rohamid/siplex-som-s16/doc/Screenshot from 2024-08-30 15-36-36.png

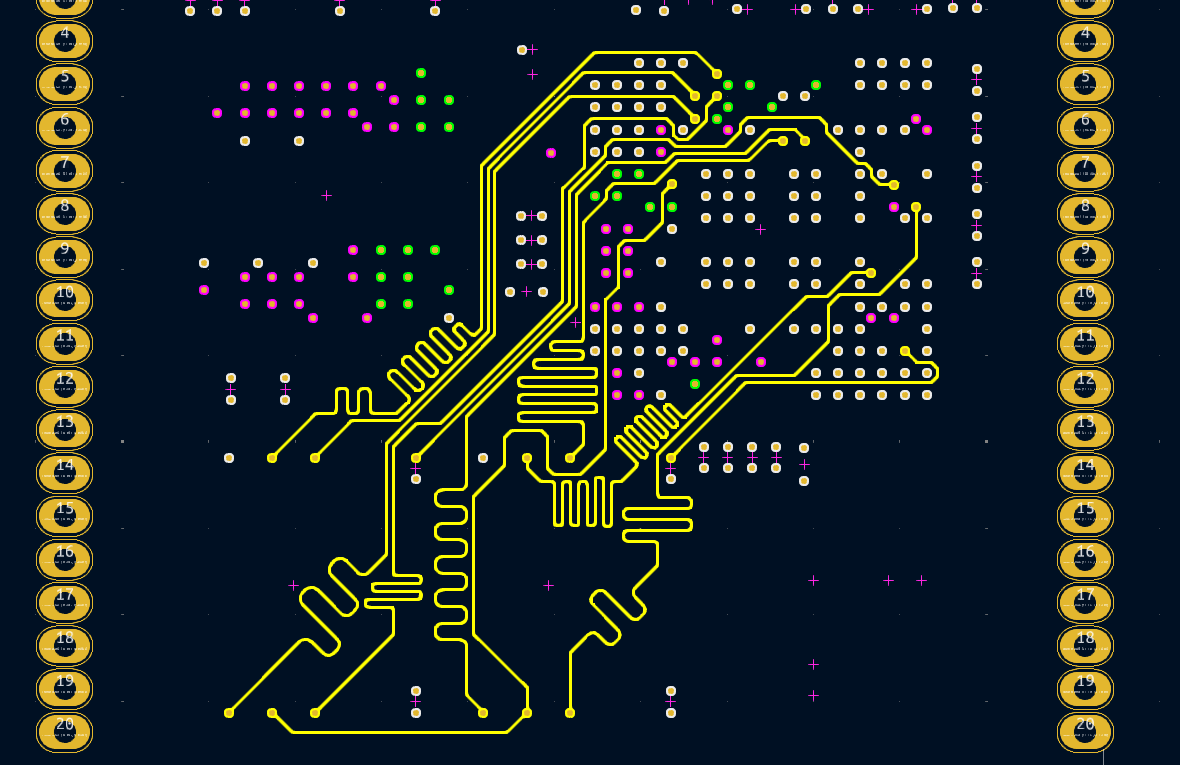
doc/Screenshot from 2024-08-30 15-36-36.png
