rohamid/siplex-som-s16/siplex-som-s16.step

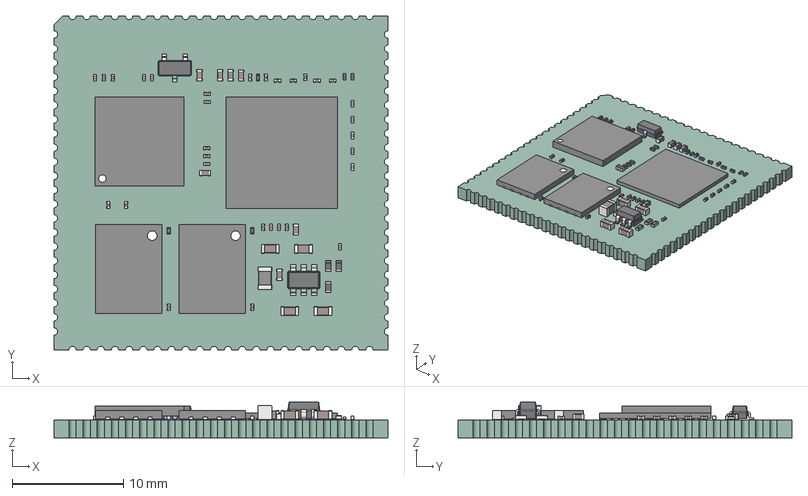
[picture p4: CAD file, 2024-09-13]
siplex-som-s16.step
30.0 x 30.0 x 3.20 mm
C_0201_0603Metric x 31
C_0603_1608Metric x 4
MT25QU01GBBB1EW9-0SIT TR x 2
C_0402_1005Metric x 6
R_0201_0603Metric x 5
R_0402_1005Metric x 3
STM32F765IIK6
IS42S16400J-6BLI
L_0805_2012Metric
SOT_23
SOT_23_6
L_0402_1005Metric
siplex-som-s16_PCB
