rohamid/siplex-som-s16/doc/siplex-som-s16.pdf

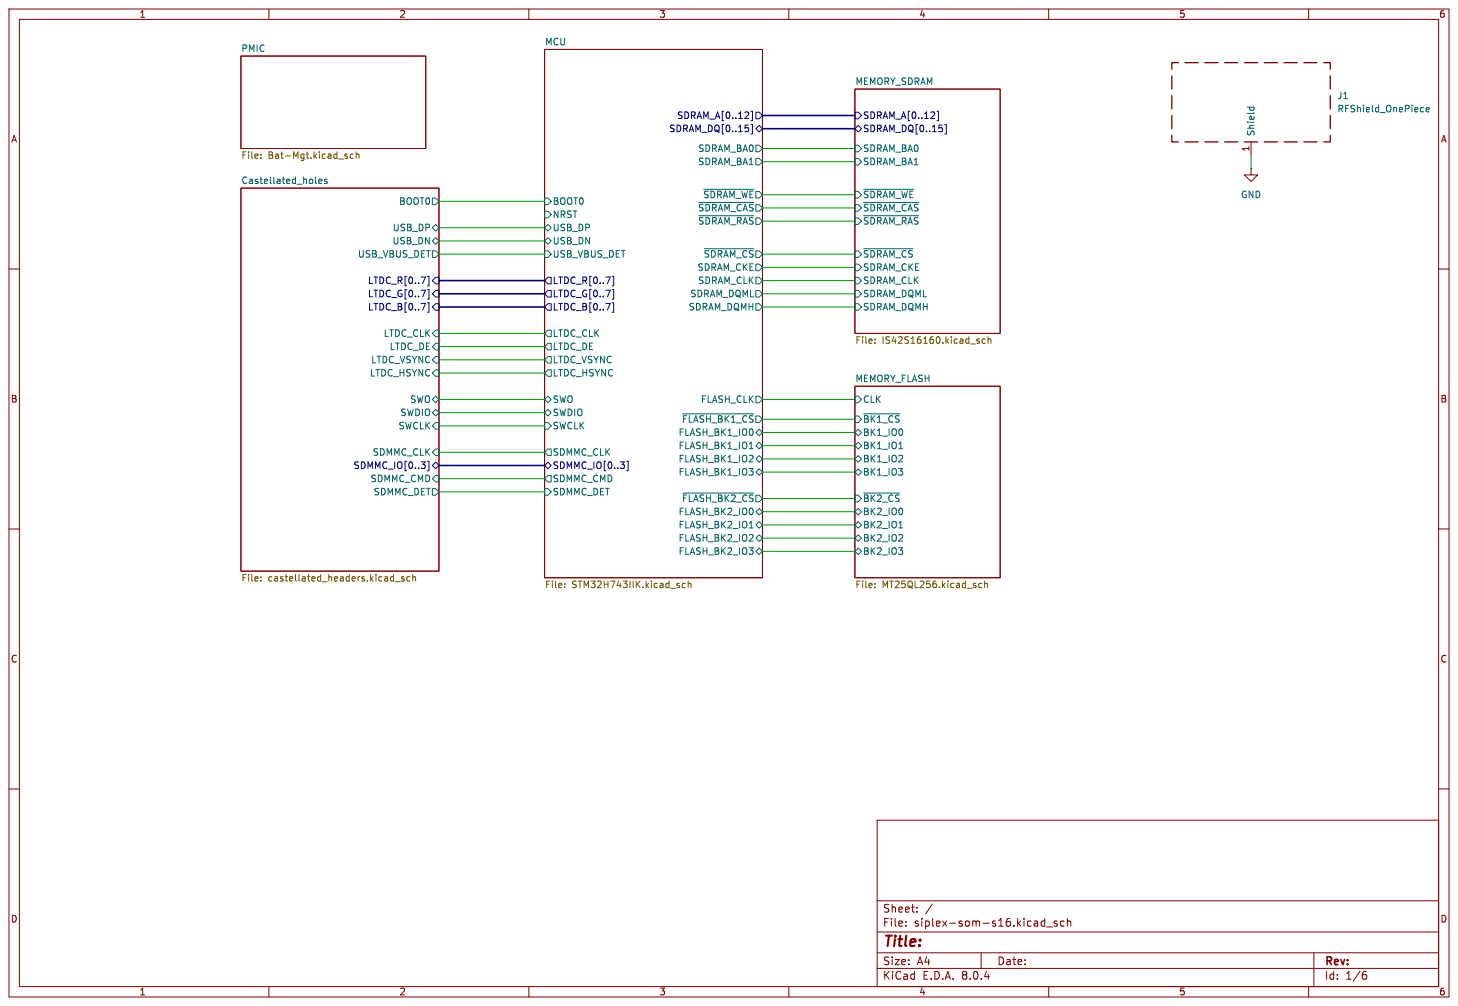
[picture p5: page 1]

~{SDRAM_CS} SDRAM_DQMH
BK2_IO3 BK1_IO2 ~{BK1_CS} BK1_IO0 BK1_IO1 BK1_IO3 MEMORY_FLASH
Id: 1/6 Title: File: siplex-som-s16.kicad_sch Sheet: / BK2_IO2 BK2_IO0 ~{BK2_CS} BK2_IO1 CLK

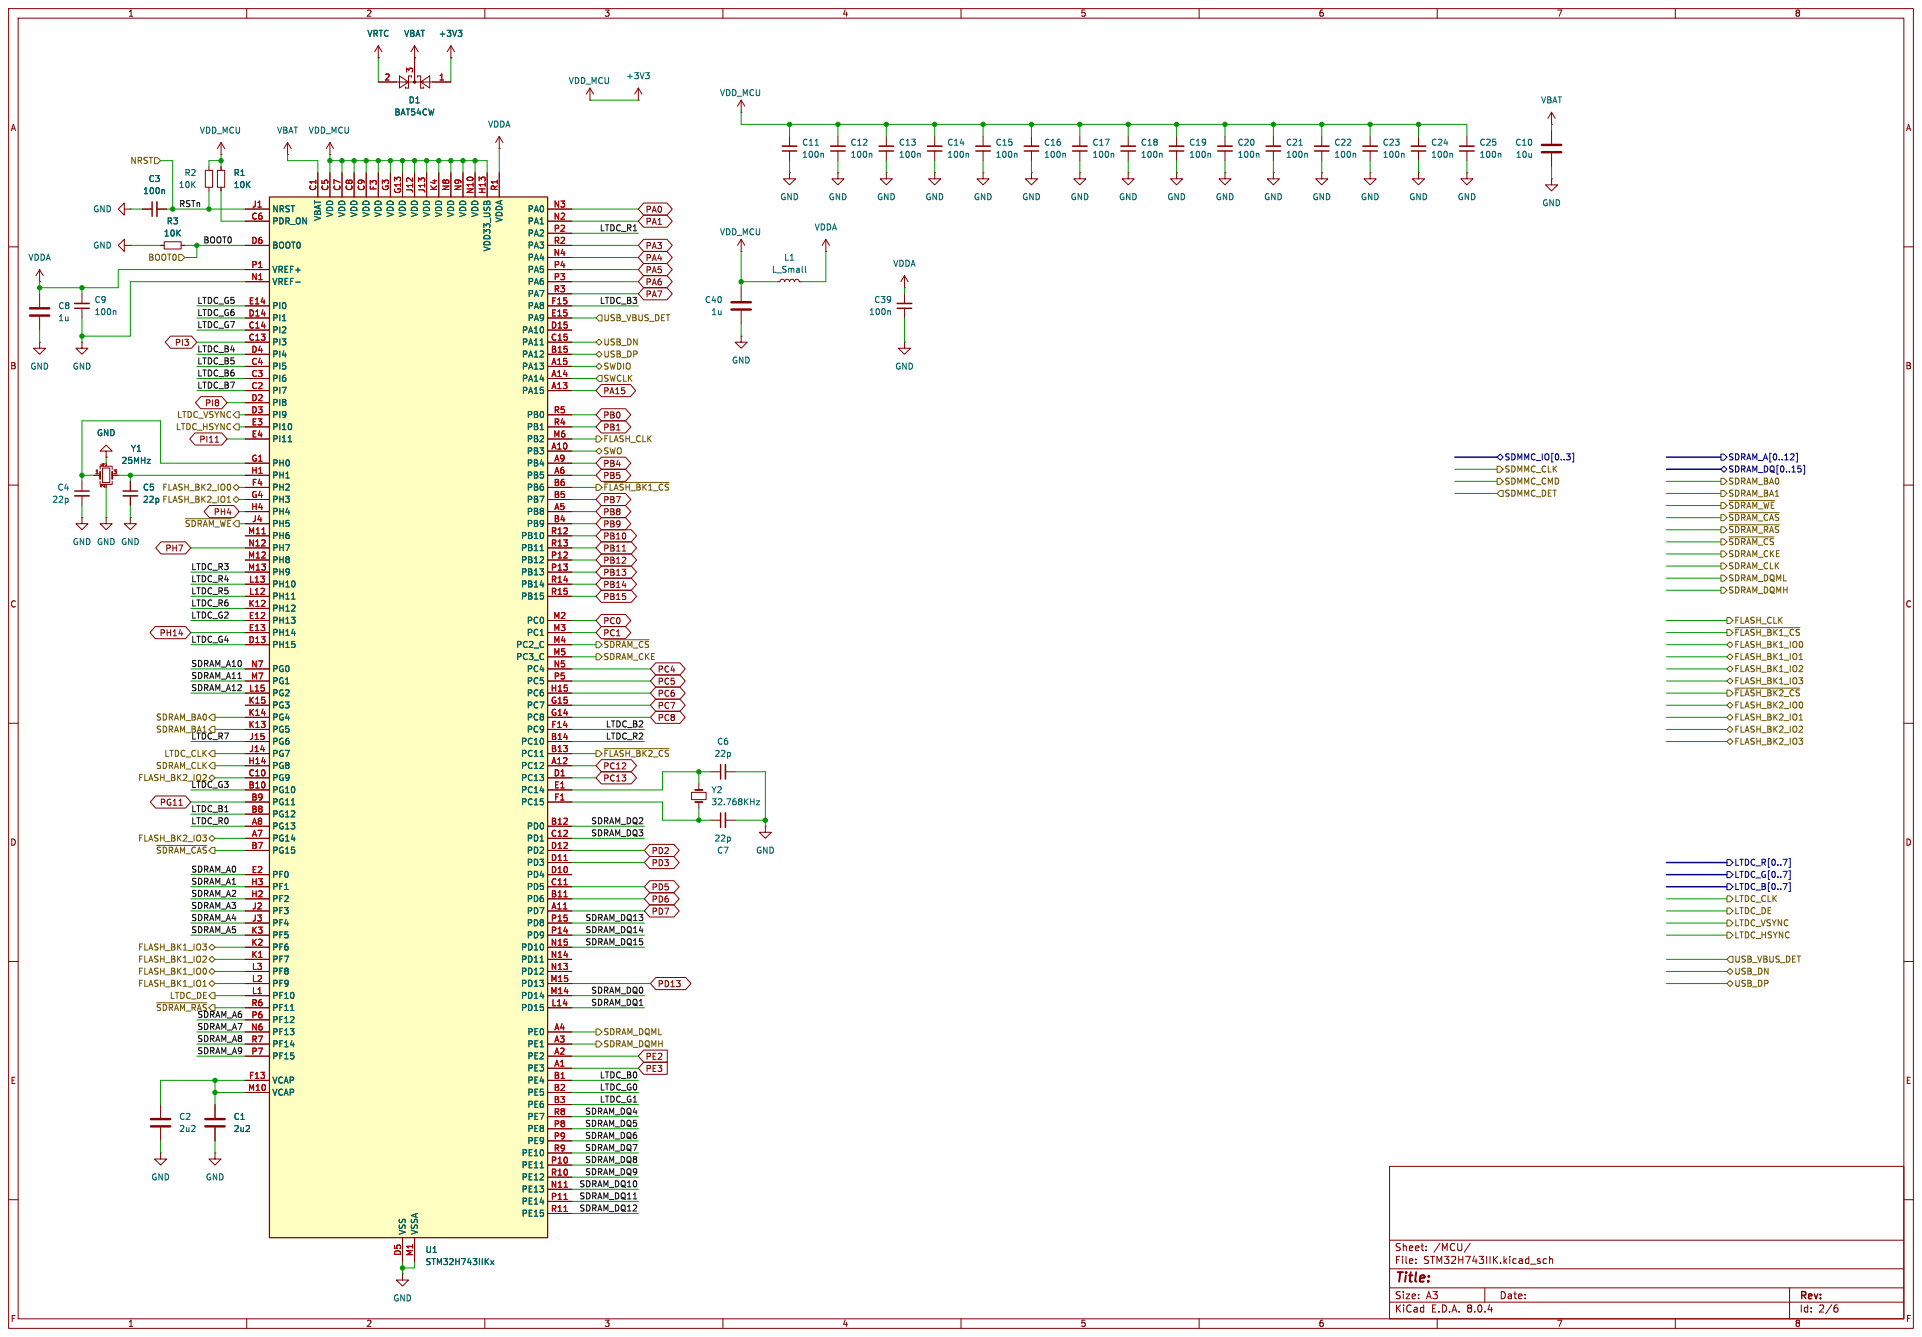
[picture p6: page 2]

Id: 2/6 Title: File: STM32H743IIK.kicad_sch Sheet: /MCU/

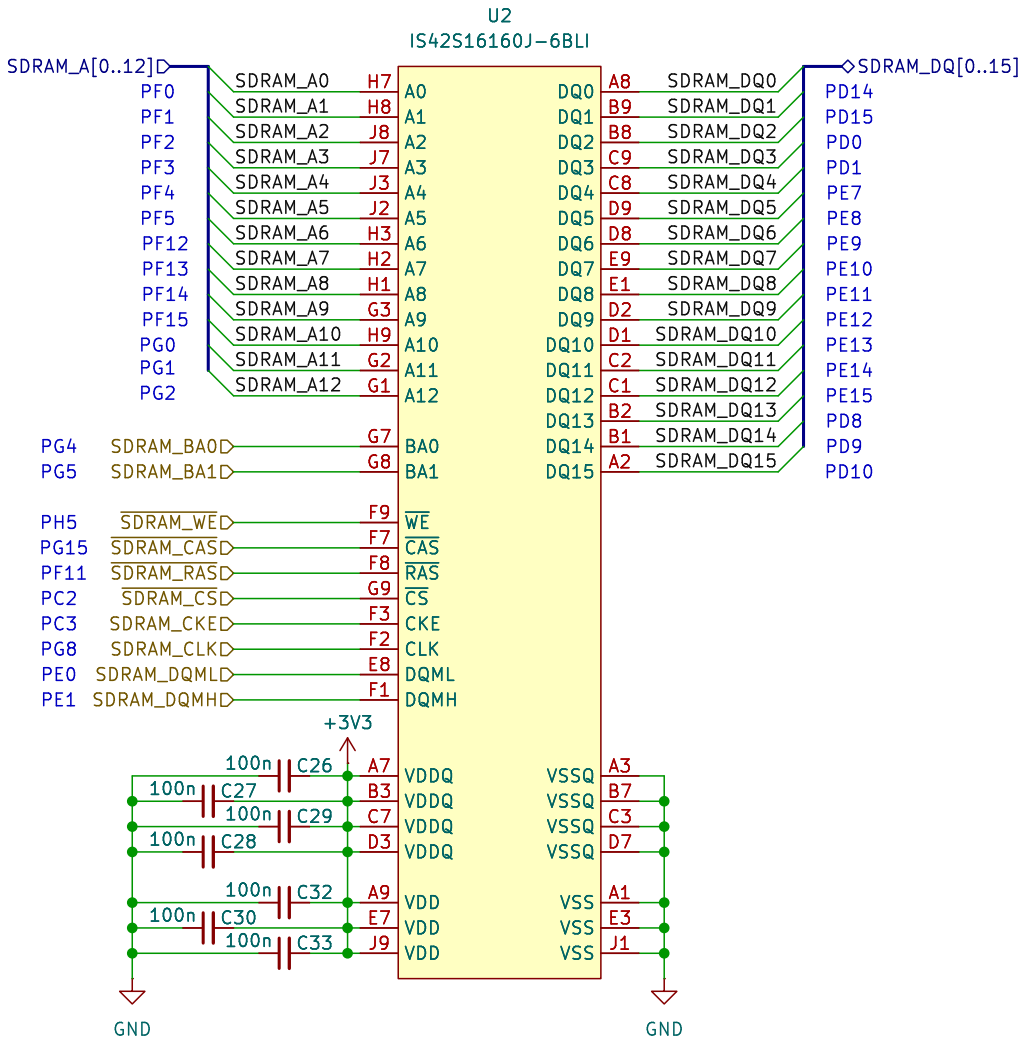
[picture p7: page 3]

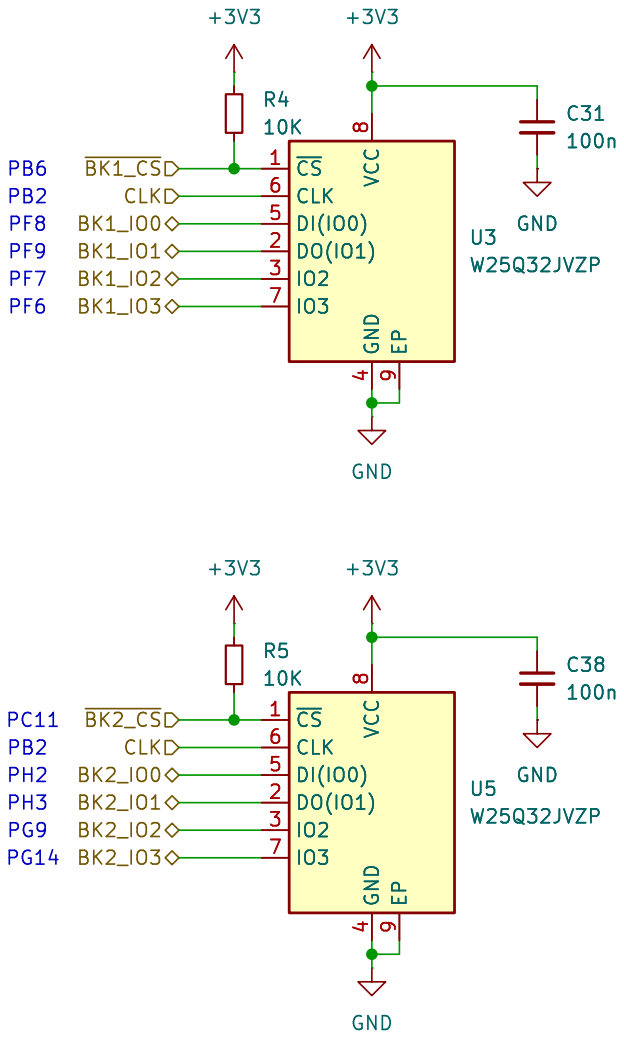
[picture p8: page 4]

Id: 4/6 Title: File: MT25QL256.kicad_sch Sheet: /MEMORY_FLASH/

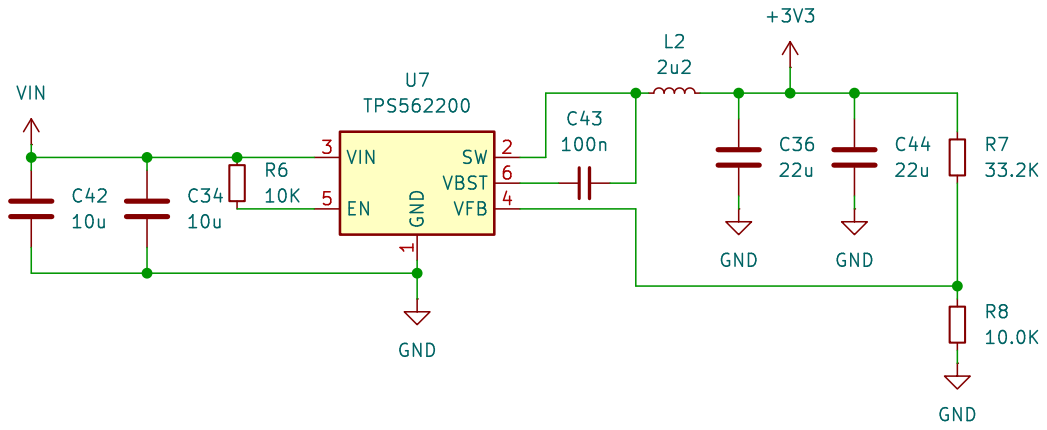
[picture p9: page 5]

1 SW 2 VIN 3 VFB 4 EN 5 VBST 6 U7 TPS562200 C42

Id: 5/6 Title: File: Bat-Mgt.kicad_sch Sheet: /PMIC/

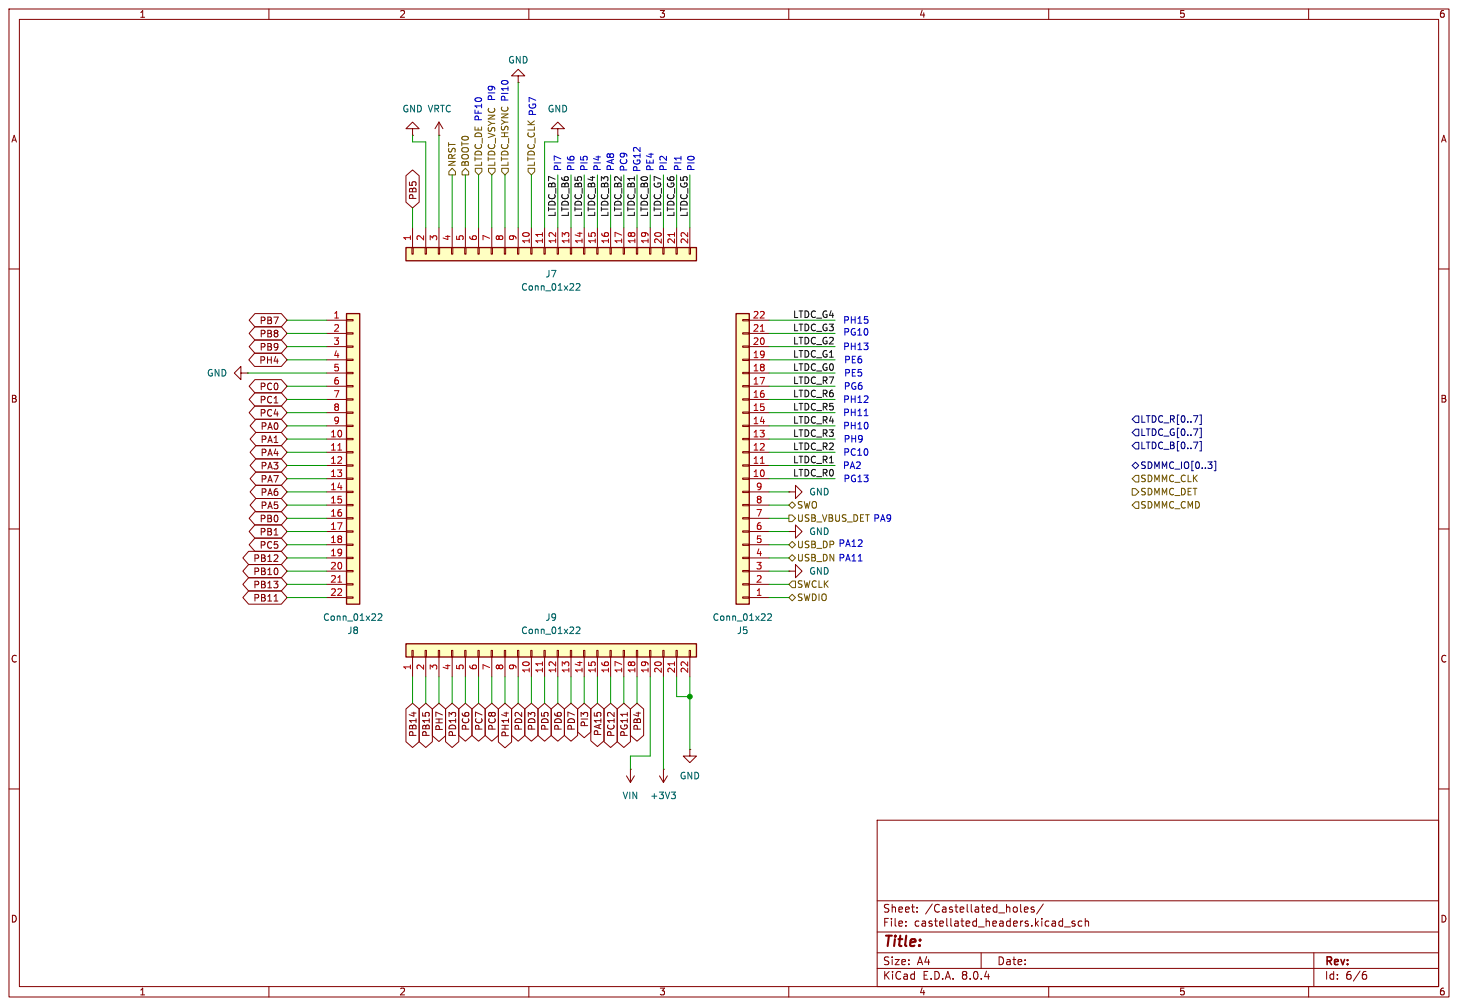
[picture p10: page 6]

Id: 6/6 Title: File: castellated_headers.kicad_sch Sheet: /Castellated_holes/
