rohamid/siplex-som-s16/siplex-som-s16.kicad_pcb

## KiCad design siplex-som-s16.kicad_pcb (2024-10-13)

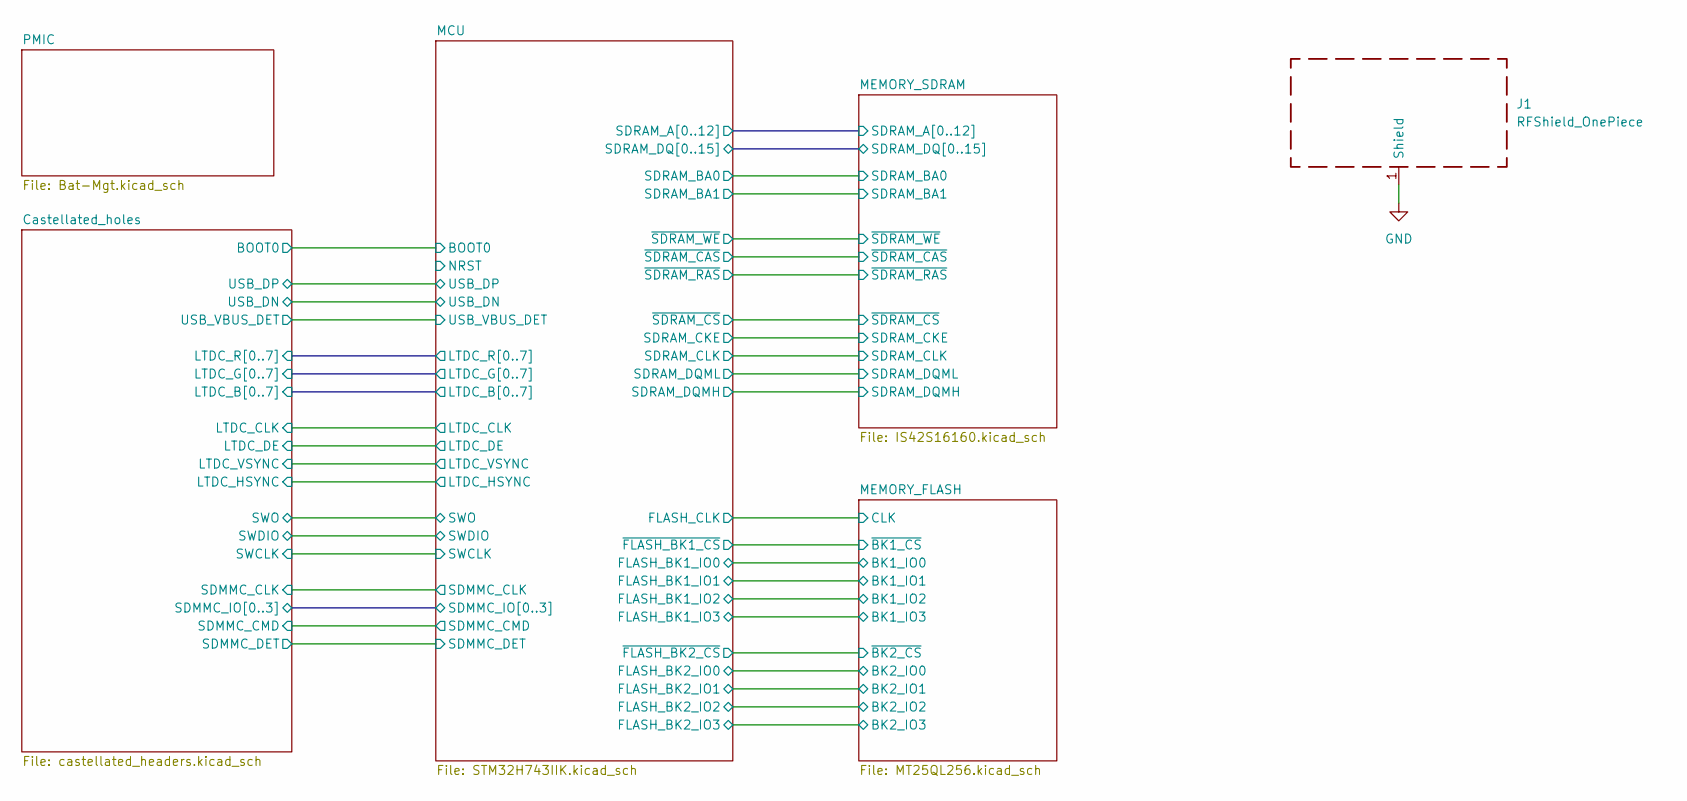
[picture p11: schematic siplex-som-s16.kicad_sch]

Parts:
J1: RFShield_OnePiece; Laird_Technologies_BMI-S-103_26.21x26.21mm

Connections:
GND: J1.1 (Shield); also elsewhere on the board

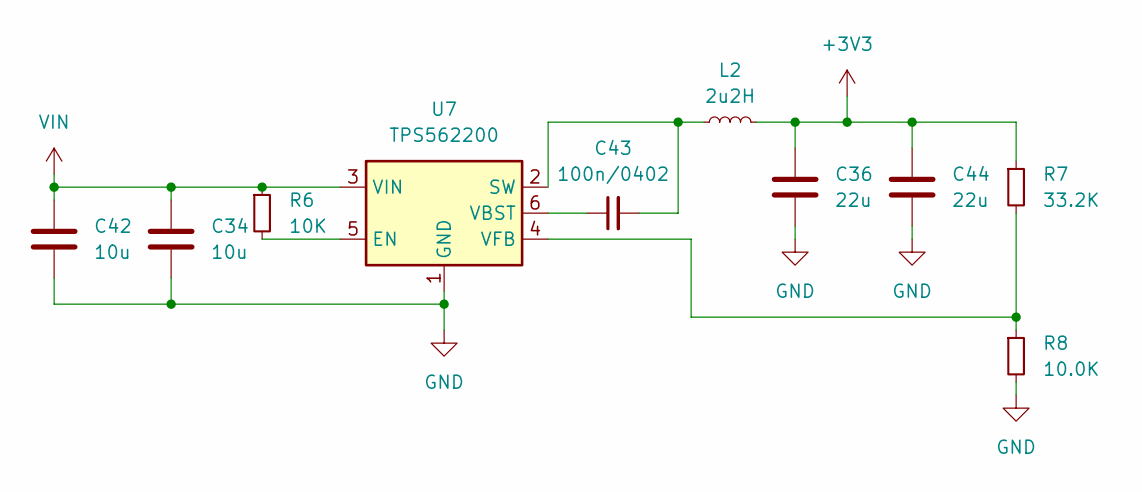
[picture p12: schematic Bat-Mgt.kicad_sch]

Parts:
C34, C42: 10u; C_0603_1608Metric; JLCPCB Part # C96446
C36, C44: 22u; C_0603_1608Metric; JLCPCB Part # C59461
C43: 100n/0402; C_0402_1005Metric; JLCPCB Part # C307331
L2: 2u2H; L_0805_2012Metric; JLCPCB Part # C162585
R6: 10K; R_0201_0603Metric; JLCPCB Part # C473048
R7: 33.2K; R_0402_1005Metric; JLCPCB Part # C226998
R8: 10.0K; R_0402_1005Metric; JLCPCB Part # C25804
U7: TPS562200; SOT-23-6; JLCPCB Part # C49757

Connections:
+3V3: C36.1, C44.1, L2.2, R7.1; also elsewhere on the board
GND: C34.2, C36.2, C42.2, C44.2, R8.2, U7.1 (GND); also elsewhere on the board
unnamed: R6.2, U7.5 (EN)
unnamed: C43.2, L2.1, U7.2 (SW)
unnamed: C43.1, U7.6 (VBST)
unnamed: R7.2, R8.1, U7.4 (VFB)
VIN: C34.1, C42.1, R6.1, U7.3 (VIN); also elsewhere on the board

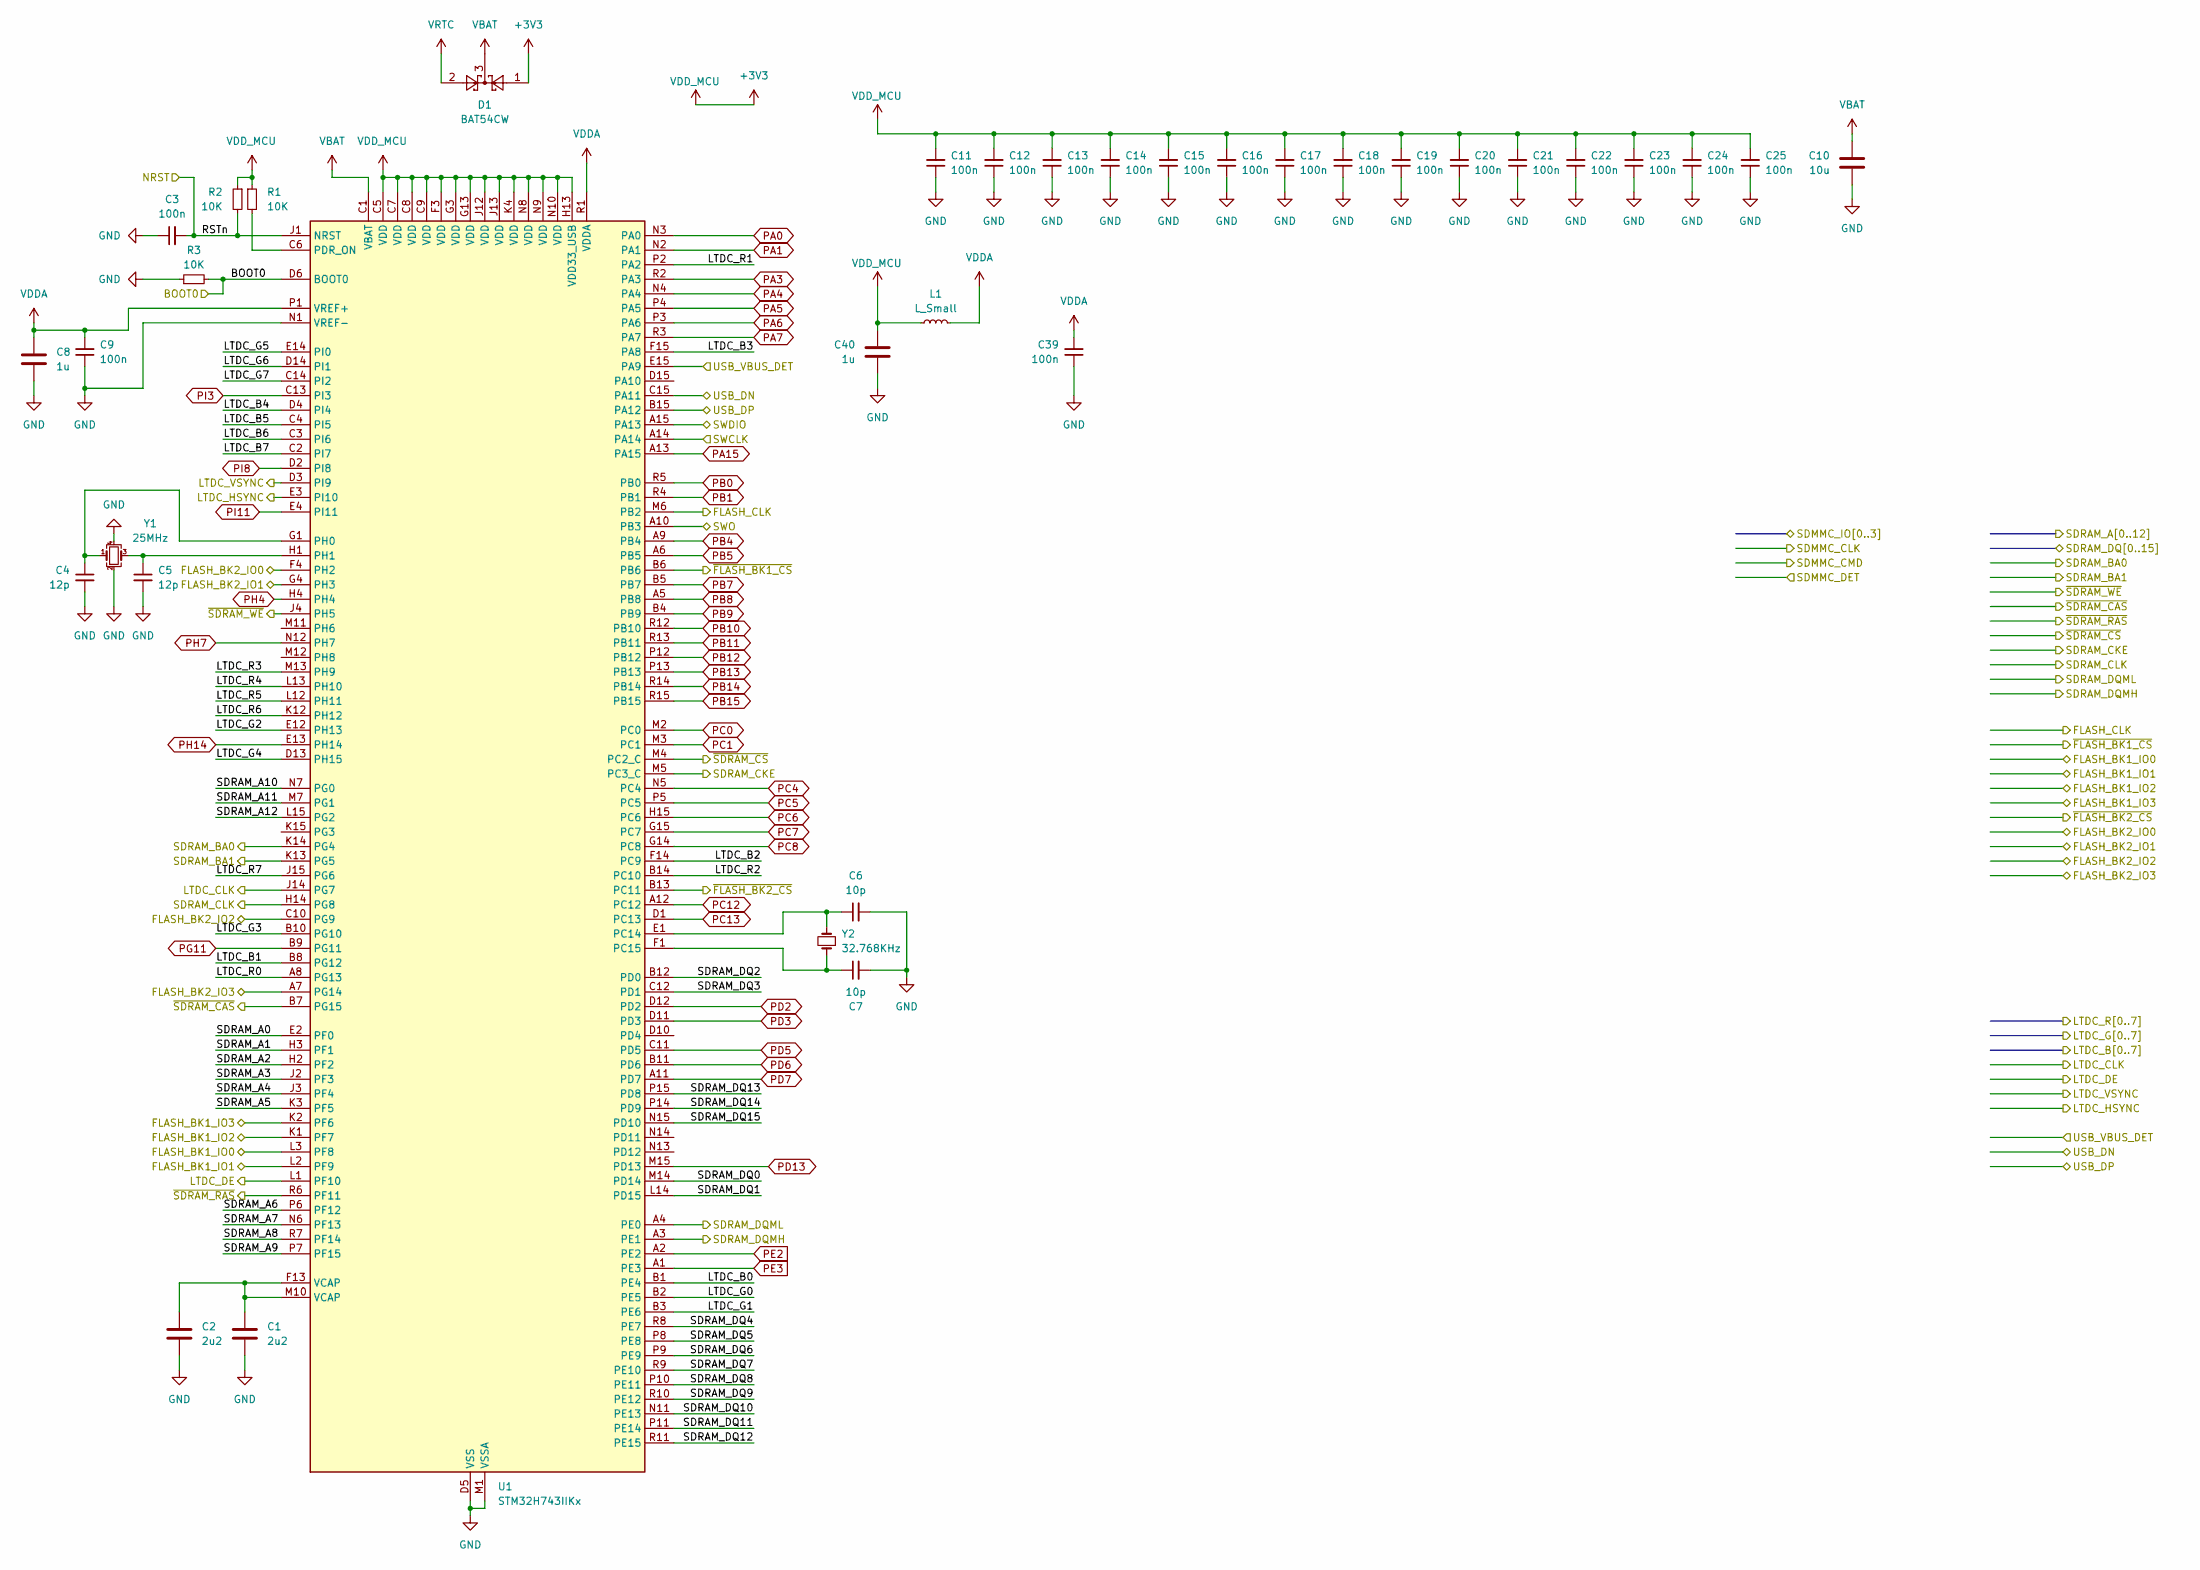
[picture p13: schematic STM32H743IIK.kicad_sch]

Parts:
C1, C2: 2u2; C_0402_1005Metric; JLCPCB Part # C12530
C3, C9, C11, C12, C13, C14, C15, C16, C17, C18, C19, C20, C21, C22, C23, C24, C25, C39: 100n; C_0201_0603Metric; JLCPCB Part # C307380
C4, C5: 12p; C_0201_0603Metric; JLCPCB Part # C277478
C6, C7: 10p; C_0201_0603Metric; JLCPCB Part # C76921
C8, C40: 1u; C_0402_1005Metric; JLCPCB Part # C52923
C10: 10u; C_0603_1608Metric; JLCPCB Part # C96446
D1: BAT54CW; SOT-23; JLCPCB Part # C37704
L1: L_Small; L_0402_1005Metric; JLCPCB Part # C76891
R1, R2, R3: 10K; R_0201_0603Metric; JLCPCB Part # C473048
U1: STM32H743IIKx; UFBGA-201_10x10mm_Layout15x15_P0.65mm; JLCPCB Part # C129442
Y1: 25MHz; Crystal_SMD_2016-4Pin_2.0x1.6mm; JLCPCB Part # C193187
Y2: 32.768KHz; Crystal_SMD_2012-2Pin_2.0x1.2mm; JLCPCB Part # C99009

Connections:
+3V3: C11.2, C12.2, C13.2, C14.2, C15.2, C16.2, C17.2, C18.2, C19.2, C20.2, C21.2, C22.2, C23.2, C24.2, C25.2, C40.1, D1.1, L1.1, R1.1, R2.1, U1.C5 (VDD), U1.C7 (VDD), U1.C8 (VDD), U1.C9 (VDD), U1.F3 (VDD), U1.G3 (VDD), U1.G13 (VDD), U1.H13 (VDD33_USB), U1.J12 (VDD), U1.J13 (VDD), U1.K4 (VDD), U1.N8 (VDD), U1.N9 (VDD), U1.N10 (VDD); also elsewhere on the board
/Castellated_holes/LTDC_B0: U1.B1 (PE4); also elsewhere on the board
/Castellated_holes/LTDC_B1: U1.B8 (PG12); also elsewhere on the board
/Castellated_holes/LTDC_B2: U1.F14 (PC9); also elsewhere on the board
/Castellated_holes/LTDC_B3: U1.F15 (PA8); also elsewhere on the board
/Castellated_holes/LTDC_B4: U1.D4 (PI4); also elsewhere on the board
/Castellated_holes/LTDC_B5: U1.C4 (PI5); also elsewhere on the board
/Castellated_holes/LTDC_B6: U1.C3 (PI6); also elsewhere on the board
/Castellated_holes/LTDC_B7: U1.C2 (PI7); also elsewhere on the board
/Castellated_holes/LTDC_CLK: U1.J14 (PG7); also elsewhere on the board
/Castellated_holes/LTDC_DE: U1.L1 (PF10); also elsewhere on the board
/Castellated_holes/LTDC_G0: U1.B2 (PE5); also elsewhere on the board
/Castellated_holes/LTDC_G1: U1.B3 (PE6); also elsewhere on the board
/Castellated_holes/LTDC_G2: U1.E12 (PH13); also elsewhere on the board
/Castellated_holes/LTDC_G3: U1.B10 (PG10); also elsewhere on the board
/Castellated_holes/LTDC_G4: U1.D13 (PH15); also elsewhere on the board
/Castellated_holes/LTDC_G5: U1.E14 (PI0); also elsewhere on the board
/Castellated_holes/LTDC_G6: U1.D14 (PI1); also elsewhere on the board
/Castellated_holes/LTDC_G7: U1.C14 (PI2); also elsewhere on the board
/Castellated_holes/LTDC_HSYNC: U1.E3 (PI10); also elsewhere on the board
/Castellated_holes/LTDC_R0: U1.A8 (PG13); also elsewhere on the board
/Castellated_holes/LTDC_R1: U1.P2 (PA2); also elsewhere on the board
/Castellated_holes/LTDC_R2: U1.B14 (PC10); also elsewhere on the board
/Castellated_holes/LTDC_R3: U1.M13 (PH9); also elsewhere on the board
/Castellated_holes/LTDC_R4: U1.L13 (PH10); also elsewhere on the board
/Castellated_holes/LTDC_R5: U1.L12 (PH11); also elsewhere on the board
/Castellated_holes/LTDC_R6: U1.K12 (PH12); also elsewhere on the board
/Castellated_holes/LTDC_R7: U1.J15 (PG6); also elsewhere on the board
/Castellated_holes/LTDC_VSYNC: U1.D3 (PI9); also elsewhere on the board
/Castellated_holes/SWCLK: U1.A14; also elsewhere on the board
/Castellated_holes/SWDIO: U1.A15 (PA13); also elsewhere on the board
/Castellated_holes/SWO: U1.A10 (PB3); also elsewhere on the board
/Castellated_holes/USB_DN: U1.C15 (PA11); also elsewhere on the board
/Castellated_holes/USB_DP: U1.B15 (PA12); also elsewhere on the board
/Castellated_holes/USB_VBUS_DET: U1.E15 (PA9); also elsewhere on the board
/MCU/BOOT0: R3.2, U1.D6 (BOOT0); also elsewhere on the board
/MCU/FLASH_BK1_IO0: U1.L3 (PF8); also elsewhere on the board
/MCU/FLASH_BK1_IO1: U1.L2 (PF9); also elsewhere on the board
/MCU/FLASH_BK1_IO2: U1.K1 (PF7); also elsewhere on the board
/MCU/FLASH_BK1_IO3: U1.K2 (PF6); also elsewhere on the board
/MCU/FLASH_BK2_IO0: U1.F4 (PH2); also elsewhere on the board
/MCU/FLASH_BK2_IO1: U1.G4 (PH3); also elsewhere on the board
/MCU/FLASH_BK2_IO2: U1.C10 (PG9); also elsewhere on the board
/MCU/FLASH_BK2_IO3: U1.A7 (PG14); also elsewhere on the board
/MCU/FLASH_CLK: U1.M6 (PB2); also elsewhere on the board
/MCU/RSTn: C3.2, R2.2, U1.J1 (NRST)
/MCU/SDRAM_A0: U1.E2 (PF0); also elsewhere on the board
/MCU/SDRAM_A1: U1.H3 (PF1); also elsewhere on the board
/MCU/SDRAM_A2: U1.H2 (PF2); also elsewhere on the board
/MCU/SDRAM_A3: U1.J2 (PF3); also elsewhere on the board
/MCU/SDRAM_A4: U1.J3 (PF4); also elsewhere on the board
/MCU/SDRAM_A5: U1.K3 (PF5); also elsewhere on the board
/MCU/SDRAM_A6: U1.P6 (PF12); also elsewhere on the board
/MCU/SDRAM_A7: U1.N6 (PF13); also elsewhere on the board
/MCU/SDRAM_A8: U1.R7 (PF14); also elsewhere on the board
/MCU/SDRAM_A9: U1.P7 (PF15); also elsewhere on the board
/MCU/SDRAM_A10: U1.N7 (PG0); also elsewhere on the board
/MCU/SDRAM_A11: U1.M7 (PG1); also elsewhere on the board
/MCU/SDRAM_A12: U1.L15 (PG2); also elsewhere on the board
/MCU/SDRAM_BA0: U1.K14 (PG4); also elsewhere on the board
/MCU/SDRAM_BA1: U1.K13 (PG5); also elsewhere on the board
/MCU/SDRAM_CKE: U1.M5 (PC3_C); also elsewhere on the board
/MCU/SDRAM_CLK: U1.H14 (PG8); also elsewhere on the board
/MCU/SDRAM_DQ0: U1.M14 (PD14); also elsewhere on the board
/MCU/SDRAM_DQ1: U1.L14 (PD15); also elsewhere on the board
/MCU/SDRAM_DQ2: U1.B12 (PD0); also elsewhere on the board
/MCU/SDRAM_DQ3: U1.C12 (PD1); also elsewhere on the board
/MCU/SDRAM_DQ4: U1.R8 (PE7); also elsewhere on the board
/MCU/SDRAM_DQ5: U1.P8 (PE8); also elsewhere on the board
/MCU/SDRAM_DQ6: U1.P9 (PE9); also elsewhere on the board
/MCU/SDRAM_DQ7: U1.R9 (PE10); also elsewhere on the board
/MCU/SDRAM_DQ8: U1.P10 (PE11); also elsewhere on the board
/MCU/SDRAM_DQ9: U1.R10 (PE12); also elsewhere on the board
/MCU/SDRAM_DQ10: U1.N11 (PE13); also elsewhere on the board
/MCU/SDRAM_DQ11: U1.P11 (PE14); also elsewhere on the board
/MCU/SDRAM_DQ12: U1.R11 (PE15); also elsewhere on the board
/MCU/SDRAM_DQ13: U1.P15 (PD8); also elsewhere on the board
/MCU/SDRAM_DQ14: U1.P14 (PD9); also elsewhere on the board
/MCU/SDRAM_DQ15: U1.N15 (PD10); also elsewhere on the board
/MCU/SDRAM_DQMH: U1.A3 (PE1); also elsewhere on the board
/MCU/SDRAM_DQML: U1.A4 (PE0); also elsewhere on the board
/MCU/~FLASH_BK1_CS: U1.B6; also elsewhere on the board
/MCU/~FLASH_BK2_CS: U1.B13 (PC11); also elsewhere on the board
/MCU/~SDRAM_CAS: U1.B7 (PG15); also elsewhere on the board
/MCU/~SDRAM_CS: U1.M4 (PC2_C); also elsewhere on the board
/MCU/~SDRAM_RAS: U1.R6 (PF11); also elsewhere on the board
/MCU/~SDRAM_WE: U1.J4 (PH5); also elsewhere on the board
GND: C1.2, C2.2, C3.1, C4.2, C5.2, C6.2, C7.2, C8.2, C9.1, C10.2, C11.1, C12.1, C13.1, C14.1, C15.1, C16.1, C17.1, C18.1, C19.1, C20.1, C21.1, C22.1, C23.1, C24.1, C25.1, C39.1, C40.2, R3.1, U1.D5 (VSS), U1.D7 (VSS), U1.D8 (VSS), U1.D9 (VSS), U1.F2 (VSS), U1.F6 (VSS), U1.F7 (VSS), U1.F8 (VSS), U1.F9 (VSS), U1.F10 (VSS), U1.F12 (VSS), U1.G2 (VSS), U1.G6 (VSS), U1.G7 (VSS), U1.G8 (VSS), U1.G9 (VSS), U1.G10 (VSS), U1.G12 (VSS), U1.H6 (VSS), U1.H7 (VSS), U1.H8 (VSS), U1.H9 (VSS), U1.H10 (VSS), U1.H12 (VSS), U1.J6 (VSS), U1.J7 (VSS), U1.J8 (VSS), U1.J9 (VSS), U1.J10 (VSS), U1.K6 (VSS), U1.K7 (VSS), U1.K8 (VSS), U1.K9 (VSS), U1.K10 (VSS), U1.L4 (VSS), U1.M1 (VSSA), U1.M8 (VSS), U1.M9 (VSS), U1.N1 (VREF-), Y1.2, Y1.4; also elsewhere on the board
unnamed: C1.1, C2.1, U1.F13 (VCAP), U1.M10 (VCAP)
unnamed: C6.1, U1.E1 (PC14), Y2.2
unnamed: C7.1, U1.F1 (PC15), Y2.1
unnamed: R1.2, U1.C6 (PDR_ON)
unnamed: C4.1, U1.G1 (PH0), Y1.1
unnamed: C5.1, U1.H1, Y1.3
PA0: U1.N3 (PA0); also elsewhere on the board
PA1: U1.N2 (PA1); also elsewhere on the board
PA3: U1.R2 (PA3); also elsewhere on the board
PA4: U1.N4 (PA4); also elsewhere on the board
PA5: U1.P4 (PA5); also elsewhere on the board
PA6: U1.P3 (PA6); also elsewhere on the board
PA7: U1.R3 (PA7); also elsewhere on the board
PA15: U1.A13 (PA15); also elsewhere on the board
PB0: U1.R5 (PB0); also elsewhere on the board
PB1: U1.R4 (PB1); also elsewhere on the board
PB4: U1.A9 (PB4); also elsewhere on the board
PB5: U1.A6 (PB5); also elsewhere on the board
PB7: U1.B5 (PB7); also elsewhere on the board
PB8: U1.A5 (PB8); also elsewhere on the board
PB9: U1.B4 (PB9); also elsewhere on the board
PB10: U1.R12 (PB10); also elsewhere on the board
PB11: U1.R13 (PB11); also elsewhere on the board
PB12: U1.P12 (PB12); also elsewhere on the board
PB13: U1.P13 (PB13); also elsewhere on the board
PB14: U1.R14 (PB14); also elsewhere on the board
PB15: U1.R15 (PB15); also elsewhere on the board
PC0: U1.M2 (PC0); also elsewhere on the board
PC1: U1.M3 (PC1); also elsewhere on the board
PC4: U1.N5 (PC4); also elsewhere on the board
PC5: U1.P5 (PC5); also elsewhere on the board
PC6: U1.H15 (PC6); also elsewhere on the board
PC7: U1.G15 (PC7); also elsewhere on the board
PC8: U1.G14 (PC8); also elsewhere on the board
PC12: U1.A12 (PC12); also elsewhere on the board
PC13: U1.D1 (PC13)
PD2: U1.D12 (PD2); also elsewhere on the board
PD3: U1.D11 (PD3); also elsewhere on the board
PD5: U1.C11 (PD5); also elsewhere on the board
PD6: U1.B11 (PD6); also elsewhere on the board
PD7: U1.A11 (PD7); also elsewhere on the board
PD13: U1.M15 (PD13); also elsewhere on the board
PE2: U1.A2 (PE2)
PE3: U1.A1 (PE3)
PG11: U1.B9 (PG11); also elsewhere on the board
PH4: U1.H4; also elsewhere on the board
PH7: U1.N12 (PH7); also elsewhere on the board
PH14: U1.E13 (PH14); also elsewhere on the board
PI3: U1.C13 (PI3); also elsewhere on the board
PI8: U1.D2 (PI8)
PI11: U1.E4 (PI11)
VBAT: C10.1, D1.3, U1.C1 (VBAT)
VDDA: C8.1, C9.2, C39.2, L1.2, U1.P1 (VREF+), U1.R1 (VDDA)
VRTC: D1.2; also elsewhere on the board

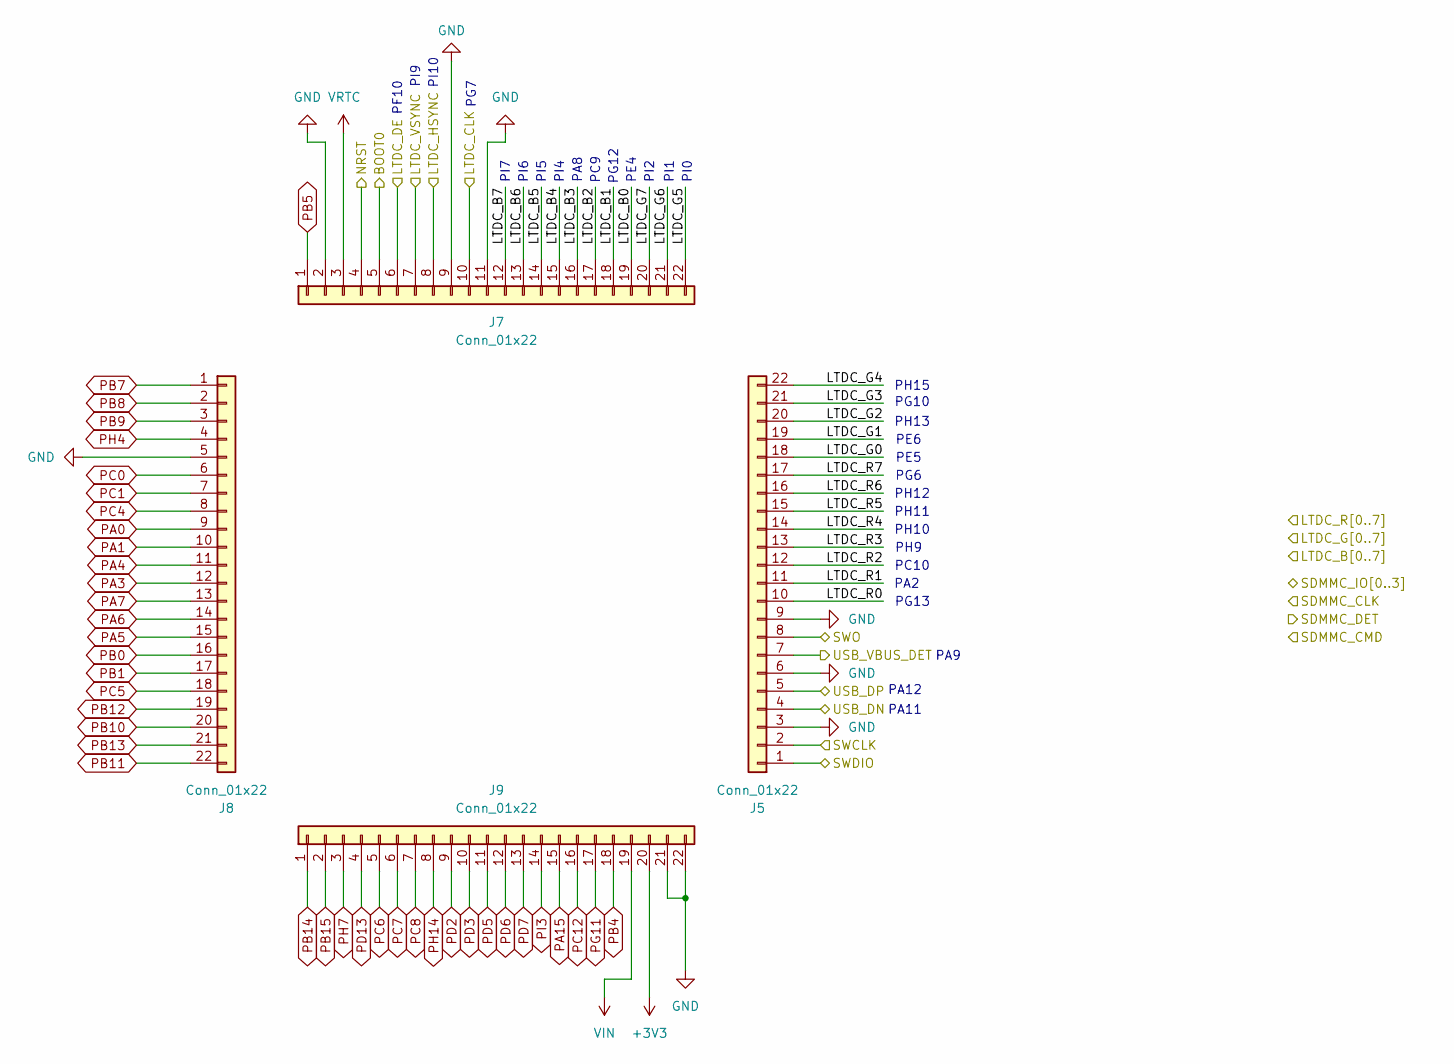
[picture p14: schematic castellated_headers.kicad_sch]

Parts:
J5, J7, J8, J9: Conn_01x22; castellated_01x22_P1.27mm

Connections:
+3V3: J9.20; also elsewhere on the board
/Castellated_holes/LTDC_B0: J7.19; also elsewhere on the board
/Castellated_holes/LTDC_B1: J7.18; also elsewhere on the board
/Castellated_holes/LTDC_B2: J7.17; also elsewhere on the board
/Castellated_holes/LTDC_B3: J7.16; also elsewhere on the board
/Castellated_holes/LTDC_B4: J7.15; also elsewhere on the board
/Castellated_holes/LTDC_B5: J7.14; also elsewhere on the board
/Castellated_holes/LTDC_B6: J7.13; also elsewhere on the board
/Castellated_holes/LTDC_B7: J7.12; also elsewhere on the board
/Castellated_holes/LTDC_CLK: J7.10; also elsewhere on the board
/Castellated_holes/LTDC_DE: J7.6; also elsewhere on the board
/Castellated_holes/LTDC_G0: J5.18; also elsewhere on the board
/Castellated_holes/LTDC_G1: J5.19; also elsewhere on the board
/Castellated_holes/LTDC_G2: J5.20; also elsewhere on the board
/Castellated_holes/LTDC_G3: J5.21; also elsewhere on the board
/Castellated_holes/LTDC_G4: J5.22; also elsewhere on the board
/Castellated_holes/LTDC_G5: J7.22; also elsewhere on the board
/Castellated_holes/LTDC_G6: J7.21; also elsewhere on the board
/Castellated_holes/LTDC_G7: J7.20; also elsewhere on the board
/Castellated_holes/LTDC_HSYNC: J7.8; also elsewhere on the board
/Castellated_holes/LTDC_R0: J5.10; also elsewhere on the board
/Castellated_holes/LTDC_R1: J5.11; also elsewhere on the board
/Castellated_holes/LTDC_R2: J5.12; also elsewhere on the board
/Castellated_holes/LTDC_R3: J5.13; also elsewhere on the board
/Castellated_holes/LTDC_R4: J5.14; also elsewhere on the board
/Castellated_holes/LTDC_R5: J5.15; also elsewhere on the board
/Castellated_holes/LTDC_R6: J5.16; also elsewhere on the board
/Castellated_holes/LTDC_R7: J5.17; also elsewhere on the board
/Castellated_holes/LTDC_VSYNC: J7.7; also elsewhere on the board
/Castellated_holes/NRST: J7.4
/Castellated_holes/SWCLK: J5.2; also elsewhere on the board
/Castellated_holes/SWDIO: J5.1; also elsewhere on the board
/Castellated_holes/SWO: J5.8; also elsewhere on the board
/Castellated_holes/USB_DN: J5.4; also elsewhere on the board
/Castellated_holes/USB_DP: J5.5; also elsewhere on the board
/Castellated_holes/USB_VBUS_DET: J5.7; also elsewhere on the board
/MCU/BOOT0: J7.5; also elsewhere on the board
GND: J5.3, J5.6, J5.9, J7.2, J7.9, J7.11, J8.5, J9.21, J9.22; also elsewhere on the board
PA0: J8.9; also elsewhere on the board
PA1: J8.10; also elsewhere on the board
PA3: J8.12; also elsewhere on the board
PA4: J8.11; also elsewhere on the board
PA5: J8.15; also elsewhere on the board
PA6: J8.14; also elsewhere on the board
PA7: J8.13; also elsewhere on the board
PA15: J9.15; also elsewhere on the board
PB0: J8.16; also elsewhere on the board
PB1: J8.17; also elsewhere on the board
PB4: J9.18; also elsewhere on the board
PB5: J7.1; also elsewhere on the board
PB7: J8.1; also elsewhere on the board
PB8: J8.2; also elsewhere on the board
PB9: J8.3; also elsewhere on the board
PB10: J8.20; also elsewhere on the board
PB11: J8.22; also elsewhere on the board
PB12: J8.19; also elsewhere on the board
PB13: J8.21; also elsewhere on the board
PB14: J9.1; also elsewhere on the board
PB15: J9.2; also elsewhere on the board
PC0: J8.6; also elsewhere on the board
PC1: J8.7; also elsewhere on the board
PC4: J8.8; also elsewhere on the board
PC5: J8.18; also elsewhere on the board
PC6: J9.5; also elsewhere on the board
PC7: J9.6; also elsewhere on the board
PC8: J9.7; also elsewhere on the board
PC12: J9.16; also elsewhere on the board
PD2: J9.9; also elsewhere on the board
PD3: J9.10; also elsewhere on the board
PD5: J9.11; also elsewhere on the board
PD6: J9.12; also elsewhere on the board
PD7: J9.13; also elsewhere on the board
PD13: J9.4; also elsewhere on the board
PG11: J9.17; also elsewhere on the board
PH4: J8.4; also elsewhere on the board
PH7: J9.3; also elsewhere on the board
PH14: J9.8; also elsewhere on the board
PI3: J9.14; also elsewhere on the board
VIN: J9.19; also elsewhere on the board
VRTC: J7.3; also elsewhere on the board

Notes on the sheet:
PC10
PI1
PA9
PI6
PG12
PF10
PI7
PI9
PA11
PA12
PG10
PI5
PG7
PI10
PH11
PH15
PI4
PG13
PC9
PH9
PI2
PH13
PA2
PH12
PH10
PA8
PE5
PE4
PI0
PG6
PE6

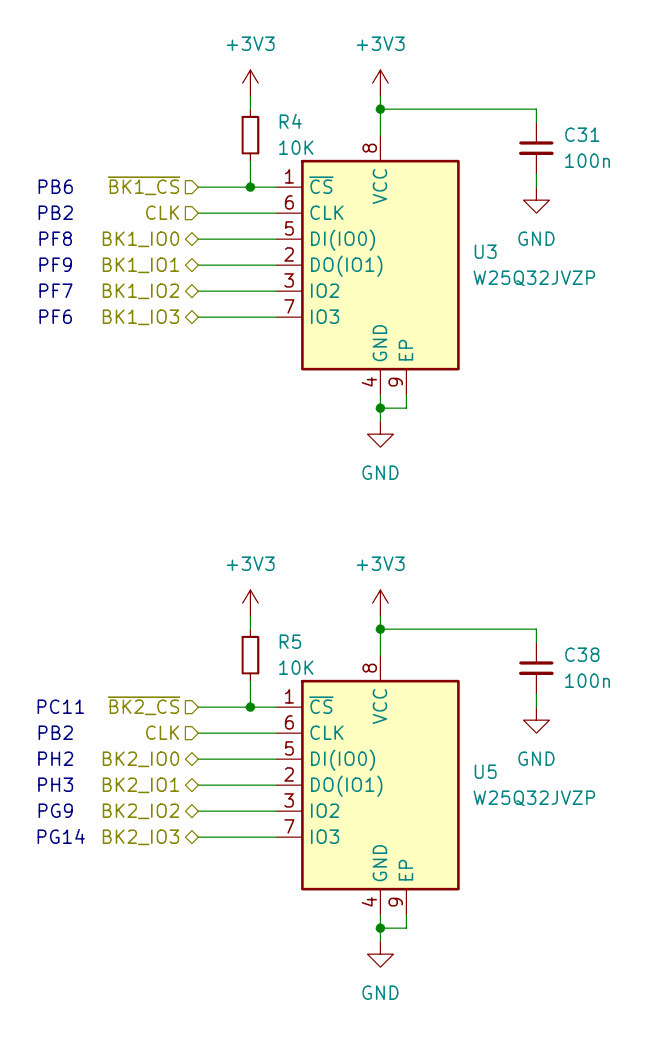
[picture p15: schematic MT25QL256.kicad_sch]

Parts:
C31, C38: 100n; C_0201_0603Metric; JLCPCB Part # C307380
R4, R5: 10K; R_0201_0603Metric; JLCPCB Part # C473048
U3, U5: W25Q32JVZP; WSON-8-1EP_8x6mm_P1.27mm_EP3.4x4.3mm; JLCPCB Part # C2986165

Connections:
+3V3: C31.1, C38.1, R4.1, R5.1, U3.8 (VCC), U5.8 (VCC); also elsewhere on the board
/MCU/FLASH_BK1_IO0: U3.5 (DI(IO0)); also elsewhere on the board
/MCU/FLASH_BK1_IO1: U3.2 (DO(IO1)); also elsewhere on the board
/MCU/FLASH_BK1_IO2: U3.3 (IO2); also elsewhere on the board
/MCU/FLASH_BK1_IO3: U3.7 (IO3); also elsewhere on the board
/MCU/FLASH_BK2_IO0: U5.5 (DI(IO0)); also elsewhere on the board
/MCU/FLASH_BK2_IO1: U5.2 (DO(IO1)); also elsewhere on the board
/MCU/FLASH_BK2_IO2: U5.3 (IO2); also elsewhere on the board
/MCU/FLASH_BK2_IO3: U5.7 (IO3); also elsewhere on the board
/MCU/FLASH_CLK: U3.6 (CLK), U5.6 (CLK); also elsewhere on the board
/MCU/~FLASH_BK1_CS: R4.2, U3.1 (~CS); also elsewhere on the board
/MCU/~FLASH_BK2_CS: R5.2, U5.1 (~CS); also elsewhere on the board
GND: C31.2, C38.2, U3.4 (GND), U3.9 (EP), U5.4 (GND), U5.9 (EP); also elsewhere on the board

Notes on the sheet:
PB6
PB2
PF7
PF8
PG9
PF6
PG14
PH3
PC11
PF9
PH2

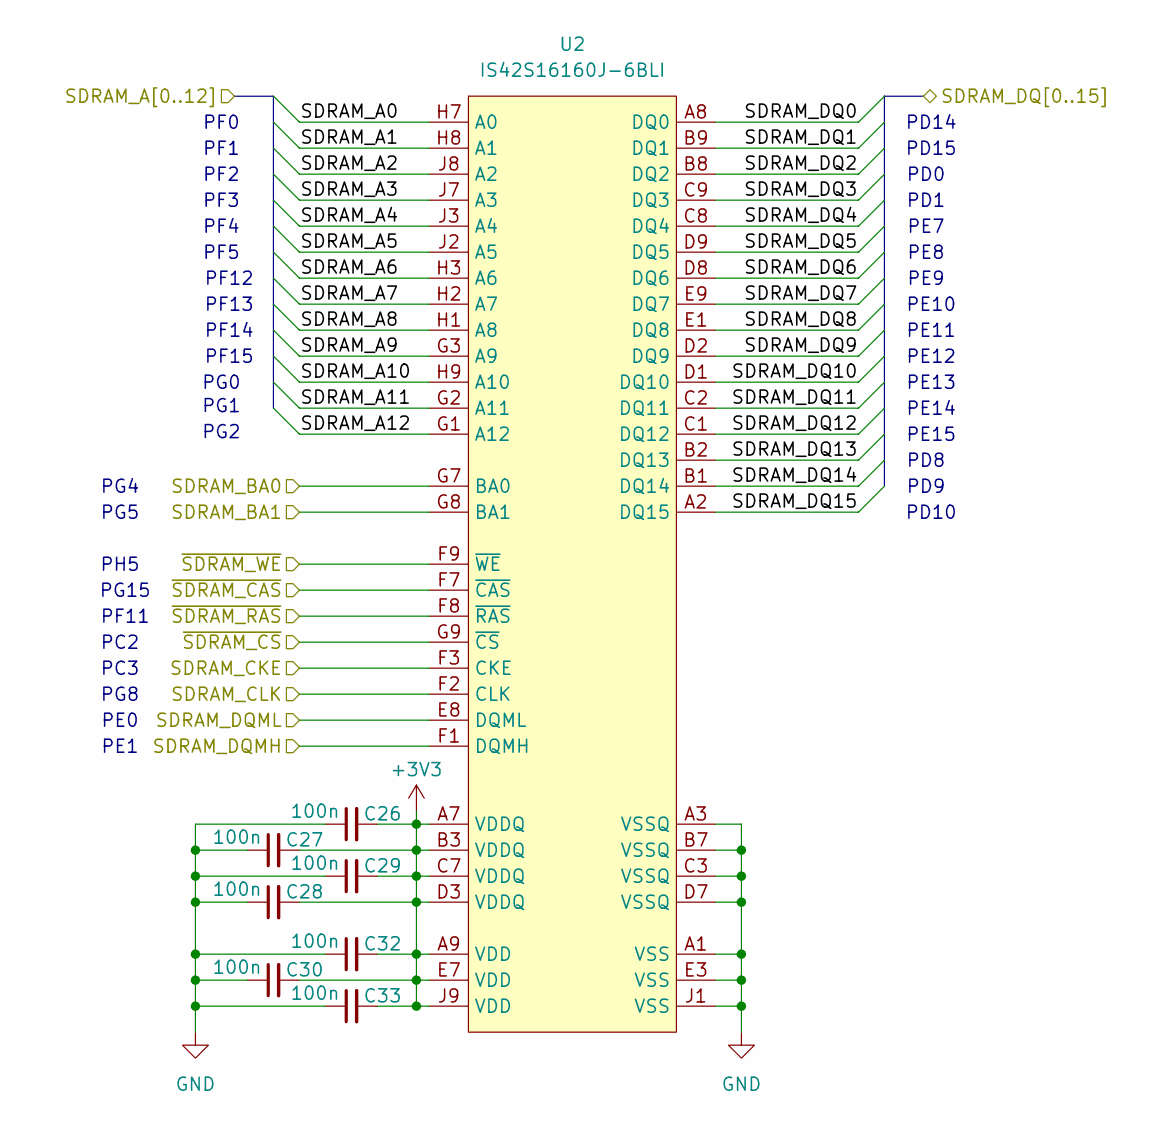
[picture p16: schematic IS42S16160.kicad_sch]

Parts:
C26, C27, C28, C29, C30, C32, C33: 100n; C_0201_0603Metric; JLCPCB Part # C307380
U2: IS42S16160J-6BLI; Alliance_TFBGA-54_8x8mm_Layout9x9_P0.8mm; JLCPCB Part # C1348766

Connections:
+3V3: C26.2, C27.2, C28.2, C29.2, C30.2, C32.2, C33.2, U2.A7 (VDDQ), U2.A9 (VDD), U2.B3 (VDDQ), U2.C7 (VDDQ), U2.D3 (VDDQ), U2.E7 (VDD), U2.J9 (VDD); also elsewhere on the board
/MCU/SDRAM_A0: U2.H7 (A0); also elsewhere on the board
/MCU/SDRAM_A1: U2.H8 (A1); also elsewhere on the board
/MCU/SDRAM_A2: U2.J8 (A2); also elsewhere on the board
/MCU/SDRAM_A3: U2.J7 (A3); also elsewhere on the board
/MCU/SDRAM_A4: U2.J3 (A4); also elsewhere on the board
/MCU/SDRAM_A5: U2.J2 (A5); also elsewhere on the board
/MCU/SDRAM_A6: U2.H3 (A6); also elsewhere on the board
/MCU/SDRAM_A7: U2.H2 (A7); also elsewhere on the board
/MCU/SDRAM_A8: U2.H1 (A8); also elsewhere on the board
/MCU/SDRAM_A9: U2.G3 (A9); also elsewhere on the board
/MCU/SDRAM_A10: U2.H9 (A10); also elsewhere on the board
/MCU/SDRAM_A11: U2.G2 (A11); also elsewhere on the board
/MCU/SDRAM_A12: U2.G1 (A12); also elsewhere on the board
/MCU/SDRAM_BA0: U2.G7 (BA0); also elsewhere on the board
/MCU/SDRAM_BA1: U2.G8 (BA1); also elsewhere on the board
/MCU/SDRAM_CKE: U2.F3 (CKE); also elsewhere on the board
/MCU/SDRAM_CLK: U2.F2 (CLK); also elsewhere on the board
/MCU/SDRAM_DQ0: U2.A8 (DQ0); also elsewhere on the board
/MCU/SDRAM_DQ1: U2.B9 (DQ1); also elsewhere on the board
/MCU/SDRAM_DQ2: U2.B8 (DQ2); also elsewhere on the board
/MCU/SDRAM_DQ3: U2.C9 (DQ3); also elsewhere on the board
/MCU/SDRAM_DQ4: U2.C8 (DQ4); also elsewhere on the board
/MCU/SDRAM_DQ5: U2.D9 (DQ5); also elsewhere on the board
/MCU/SDRAM_DQ6: U2.D8 (DQ6); also elsewhere on the board
/MCU/SDRAM_DQ7: U2.E9 (DQ7); also elsewhere on the board
/MCU/SDRAM_DQ8: U2.E1 (DQ8); also elsewhere on the board
/MCU/SDRAM_DQ9: U2.D2 (DQ9); also elsewhere on the board
/MCU/SDRAM_DQ10: U2.D1 (DQ10); also elsewhere on the board
/MCU/SDRAM_DQ11: U2.C2 (DQ11); also elsewhere on the board
/MCU/SDRAM_DQ12: U2.C1 (DQ12); also elsewhere on the board
/MCU/SDRAM_DQ13: U2.B2 (DQ13); also elsewhere on the board
/MCU/SDRAM_DQ14: U2.B1 (DQ14); also elsewhere on the board
/MCU/SDRAM_DQ15: U2.A2 (DQ15); also elsewhere on the board
/MCU/SDRAM_DQMH: U2.F1 (DQMH); also elsewhere on the board
/MCU/SDRAM_DQML: U2.E8 (DQML); also elsewhere on the board
/MCU/~SDRAM_CAS: U2.F7 (~CAS); also elsewhere on the board
/MCU/~SDRAM_CS: U2.G9 (~CS); also elsewhere on the board
/MCU/~SDRAM_RAS: U2.F8 (~RAS); also elsewhere on the board
/MCU/~SDRAM_WE: U2.F9 (~WE); also elsewhere on the board
GND: C26.1, C27.1, C28.1, C29.1, C30.1, C32.1, C33.1, U2.A1 (VSS), U2.A3 (VSSQ), U2.B7 (VSSQ), U2.C3 (VSSQ), U2.D7 (VSSQ), U2.E3 (VSS), U2.J1 (VSS); also elsewhere on the board

Notes on the sheet:
PE15
PD9
PD0
PF0
PE8
PF1
PE9
PG1
PC2
PF5
PG5
PE0
PD10
PF14
PE12
PF15
PD1
PG4
PG8
PC3
PD8
PE13
PF13
PF4
PD14
PF11
PF12
PG0
PE1
PH5
PG2
PE14
PD15
PF3
PG15
PE10
PE11
PF2
PE7

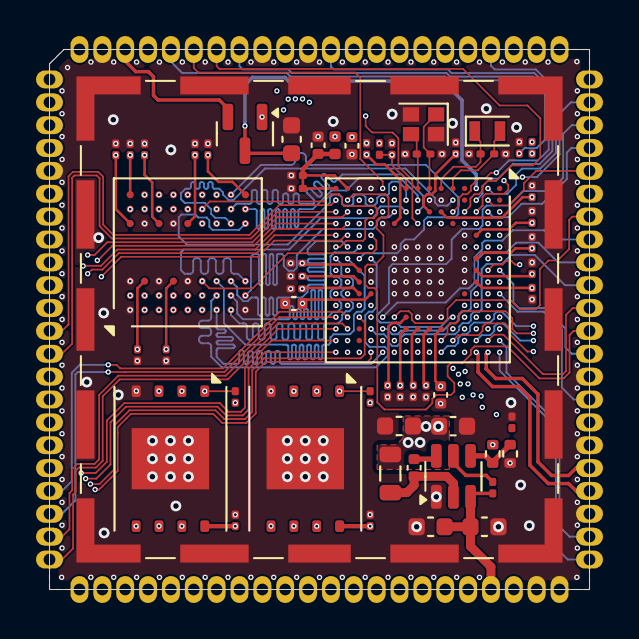
[picture p17: board siplex-som-s16.kicad_pcb from above]

Board: 8 copper layers, 30.0 x 30.0 mm, 64 parts (0 on the bottom side), 142 nets.
