rohamid/siplex-som-s16/(commit log)

2024-08-26 Add power
    [Bat-Mgt.kicad_sch, MT25QL256.kicad_sch, STM32H743IIK.kicad_sch, siplex-som-s16.kicad_pcb, siplex-som-s16.kicad_sch]
2024-08-28 Change to 8 layer, doing SDRAM traces
    [STM32H743IIK.kicad_sch, siplex-som-s16.kicad_pcb]
2024-08-29 Finished SDRAM, QSPI FLASH (trace length not matched yet)
    [MT25QL256.kicad_sch, STM32H743IIK.kicad_sch, siplex-som-s16.kicad_pcb, siplex-som-s16.kicad_sch]
2024-08-30 Change to via-in-pad mode
    [siplex-som-s16.kicad_pcb]
2024-09-02 Finished SDRAM_DATA
    [siplex-som-s16.kicad_pcb]
2024-09-03 Finished SDRAM_ADDRESS
    [siplex-som-s16.kicad_pcb]
2024-09-04 Modify SDRAM tracks as its conflicted with FLASH tracks
    [siplex-som-s16.kicad_pcb]
2024-09-04 Finished FLASH tracks
    [siplex-som-s16.kicad_pcb]
2024-09-04 Finished LTDC tracks
    [STM32H743IIK.kicad_sch, castellated_headers.kicad_sch, siplex-som-s16.kicad_pcb, siplex-som-s16.kicad_sch]
2024-09-05 test remote connection
    [STM32H743IIK.kicad_sch, castellated_headers.kicad_sch, siplex-som-s16.kicad_pcb, siplex-som-s16.kicad_sch]
2024-09-09 Finished fanout all remaining pin, Power block left
    [Bat-Mgt.kicad_sch, IS42S16160.kicad_sch, MT25QL256.kicad_sch, STM32H743IIK.kicad_sch, castellated_headers.kicad_sch, siplex-som-s16.kicad_pcb, siplex-som-s16.kicad_sch]
2024-09-10 Changed PMIC to dc-dc converter, finished track
    [Bat-Mgt.kicad_sch, castellated_headers.kicad_sch, siplex-som-s16.kicad_pcb]
2024-09-13 generate doc
    [Bat-Mgt.kicad_sch, IS42S16160.kicad_sch, MT25QL256.kicad_sch, STM32H743IIK.kicad_sch, castellated_headers.kicad_sch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]
2024-10-01 98% finished, st-link part left
    [Bat-Mgt.kicad_sch, IS42S16160.kicad_sch, MT25QL256.kicad_sch, STM32H743IIK.kicad_sch, castellated_headers.kicad_sch, siplex-som-s16.kicad_sch]
2024-10-03 Change LCD CLK, VSYNC, HSYNC, to be match with the position of standard 40 pin LCD module
    [castellated_headers.kicad_sch, siplex-som-s16.kicad_pcb]
2024-10-13 Adding JLCPCB Part #
    [Bat-Mgt.kicad_sch, IS42S16160.kicad_sch, MT25QL256.kicad_sch, STM32H743IIK.kicad_sch, castellated_headers.kicad_sch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]
